spaceth/tigers-x/public/media/mission/dock-poster.jpg

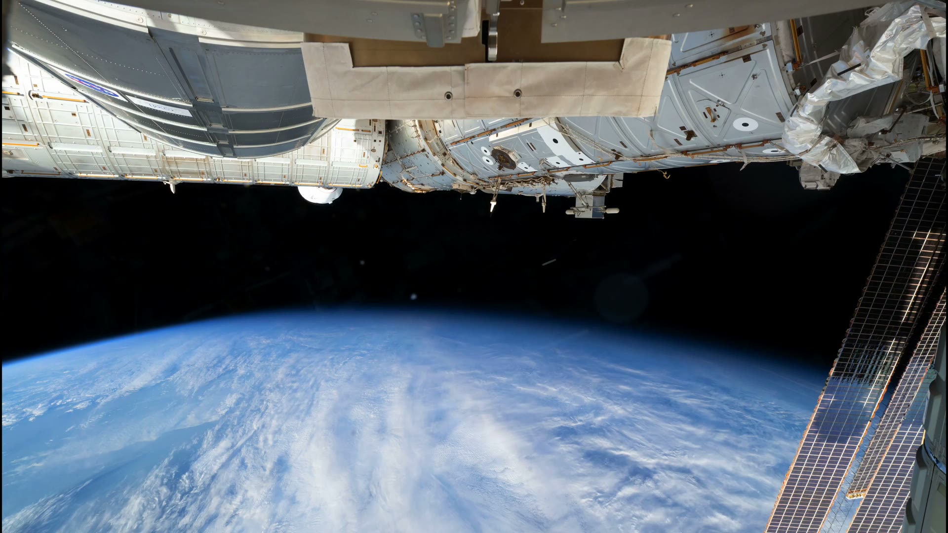
public/media/mission/dock-poster.jpg
