spaceth/tigers-x/public/media/mission/installation-poster.jpg

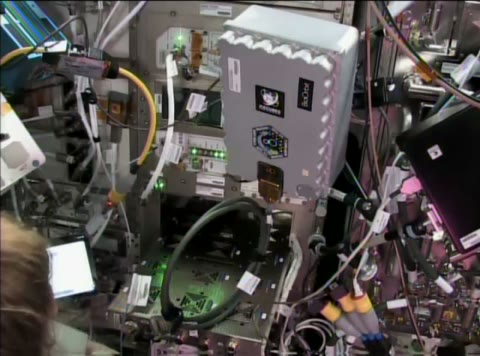
public/media/mission/installation-poster.jpg
