spaceth/tigers-x/command.png

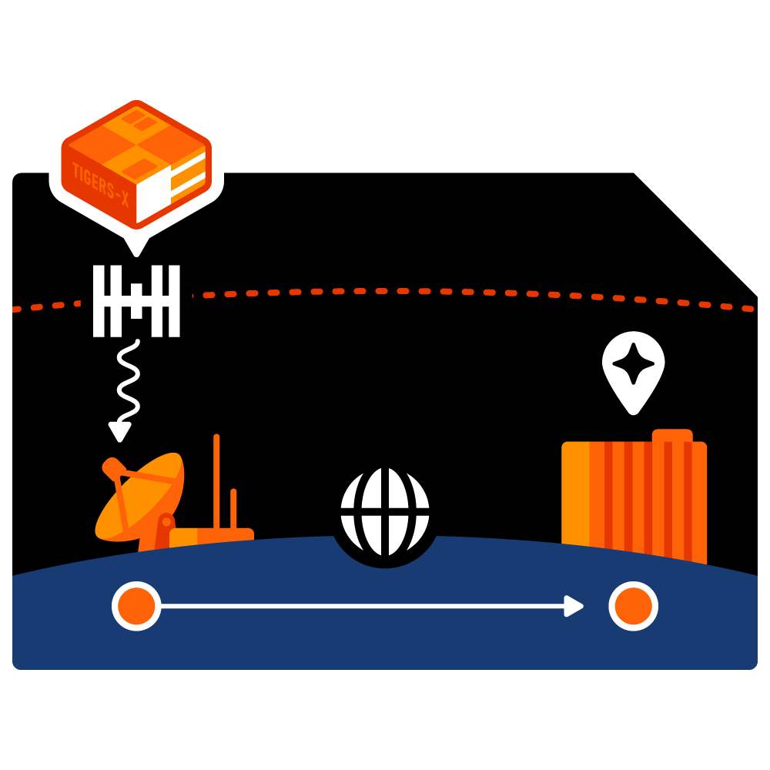
command.png
