spaceth/tigers-x/exploration.png

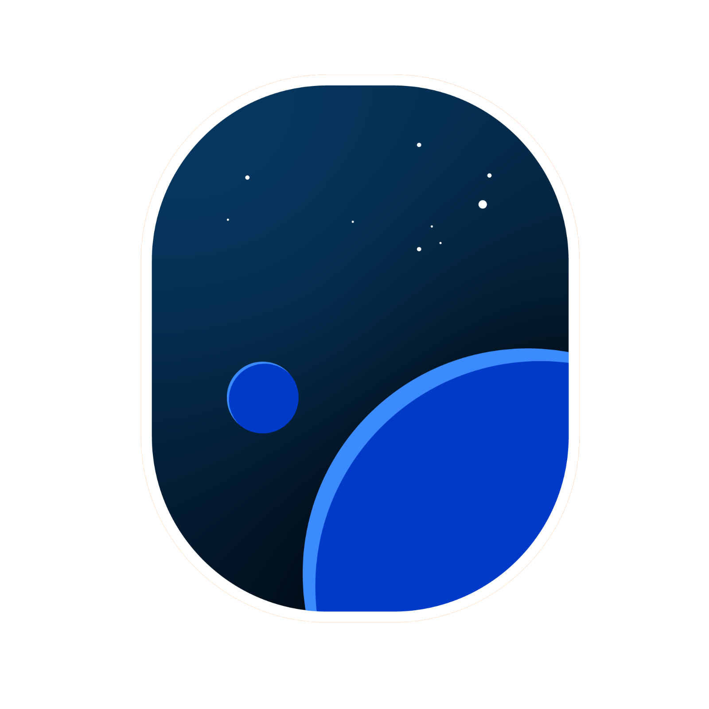
exploration.png
