spaceth/tigers-x/food.png

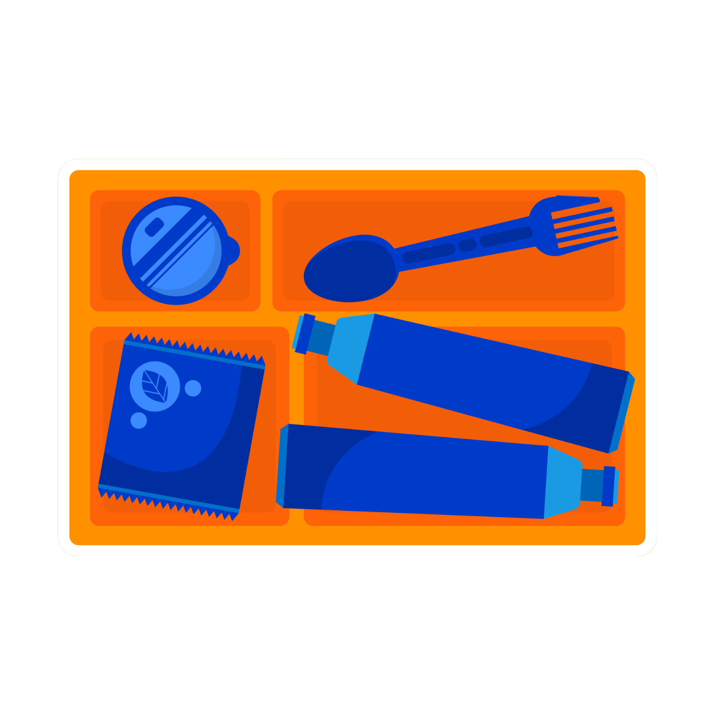
food.png
