spaceth/tigers-x/gistda.webp

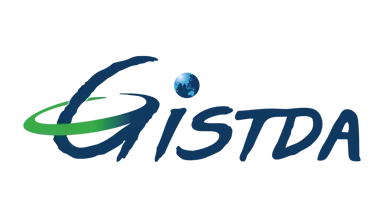
gistda.webp
