spaceth/tigers-x/medical.png

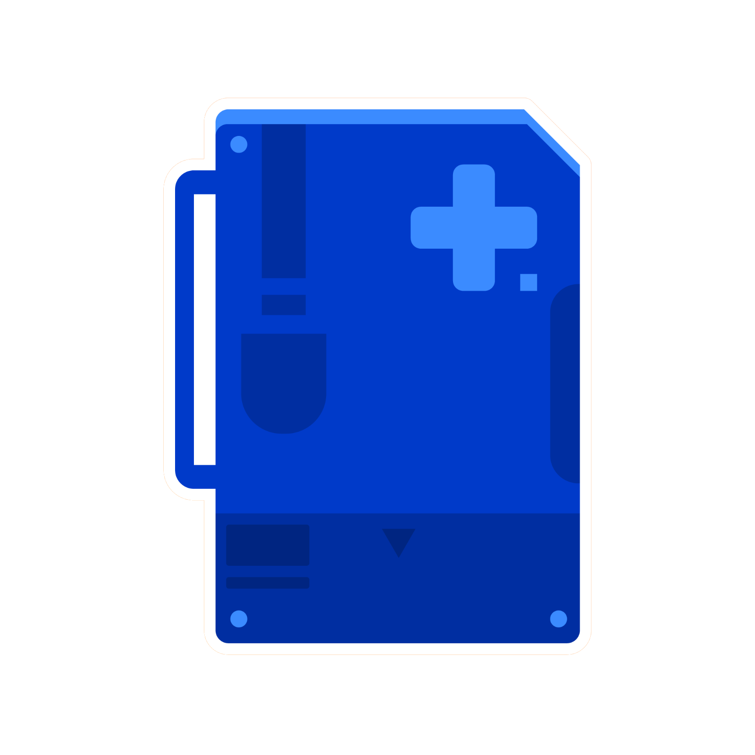
medical.png
