spaceth/tigers-x/og.png

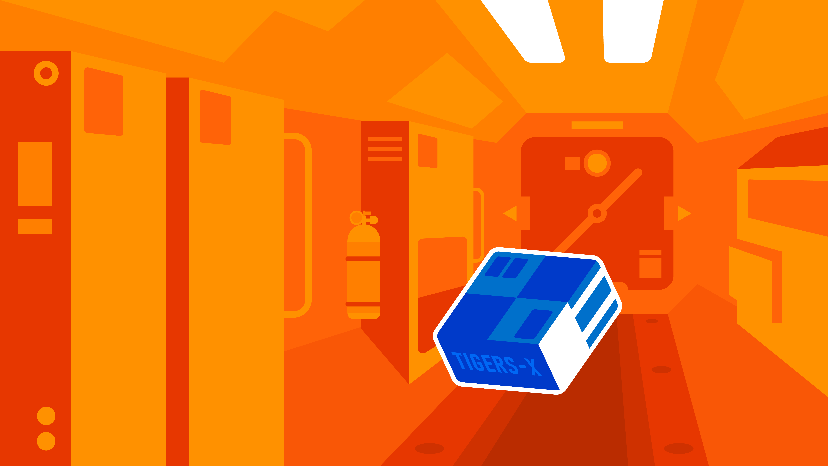
og.png
