spaceth/tigers-x/parabolic.png

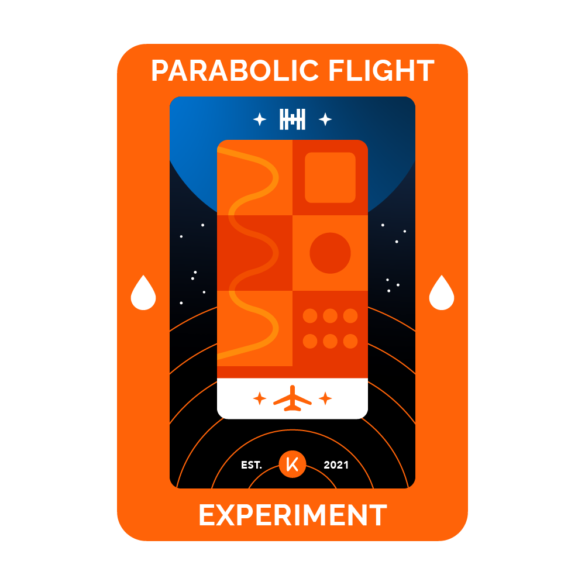
parabolic.png
