spaceth/tigers-x/pim.webp

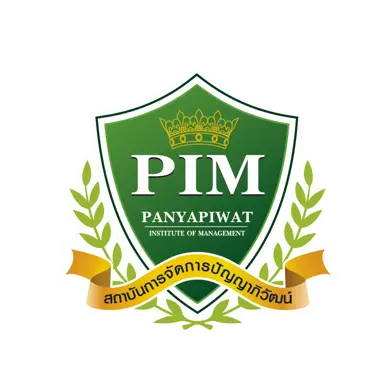
pim.webp
