spaceth/tigers-x/public/media/mission/lab-on-a-chip-poster.jpg

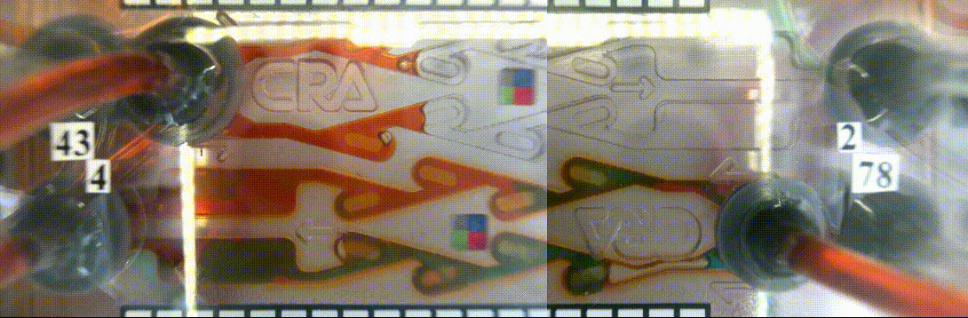
public/media/mission/lab-on-a-chip-poster.jpg
