spaceth/tigers-x/public/media/mission/launch-falcon-9.jpg

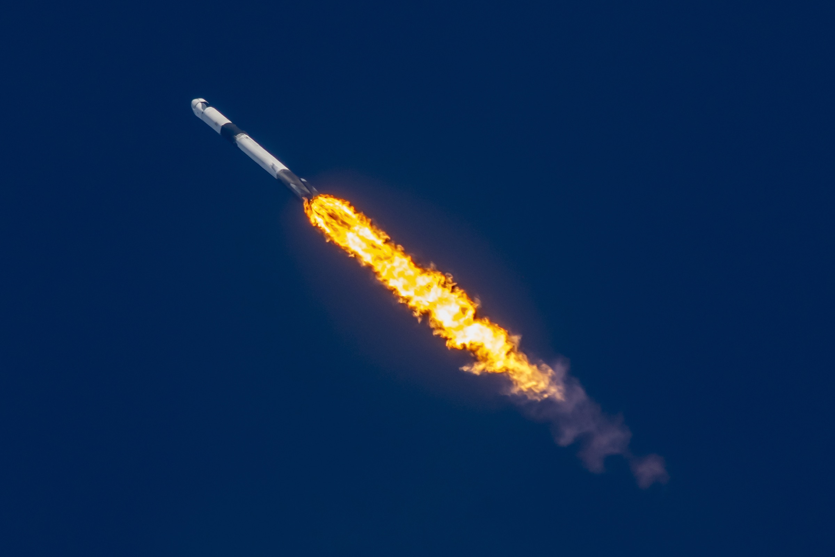
public/media/mission/launch-falcon-9.jpg
