spaceth/tigers-x/public/media/mission/launch-pad-remote.jpg

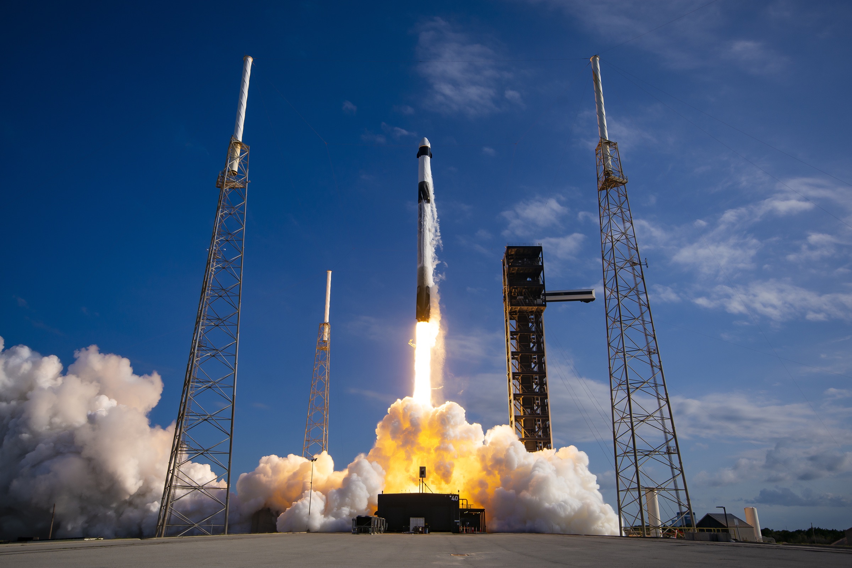
public/media/mission/launch-pad-remote.jpg
