spaceth/tigers-x/public/media/mission/launch.jpg

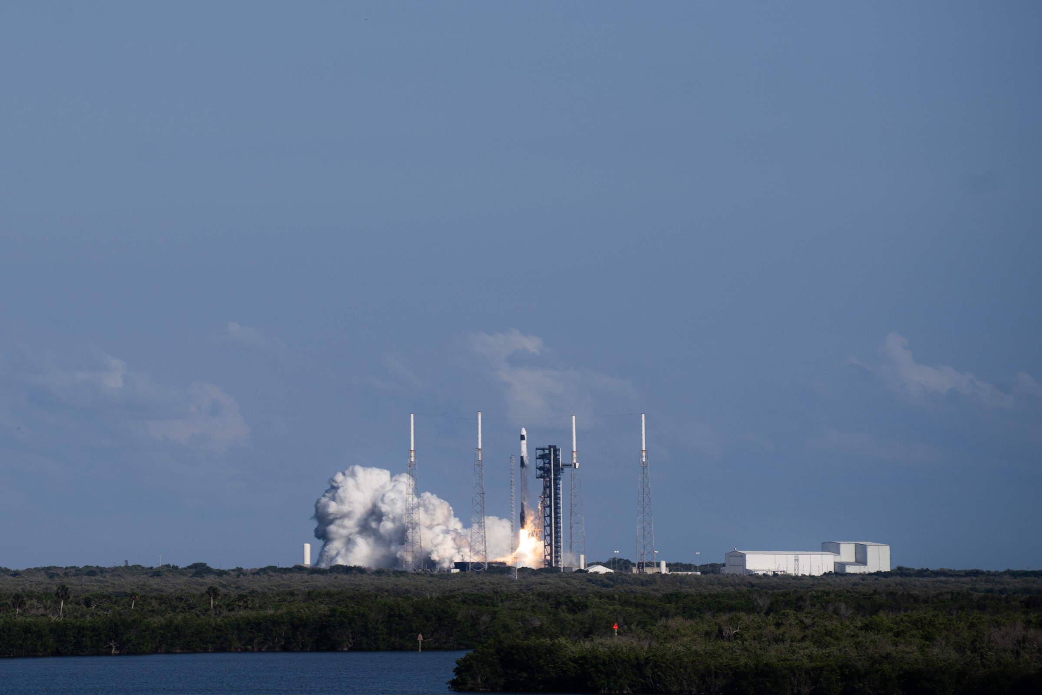
public/media/mission/launch.jpg
