spaceth/tigers-x/public/media/mission/payload-development-1.jpg

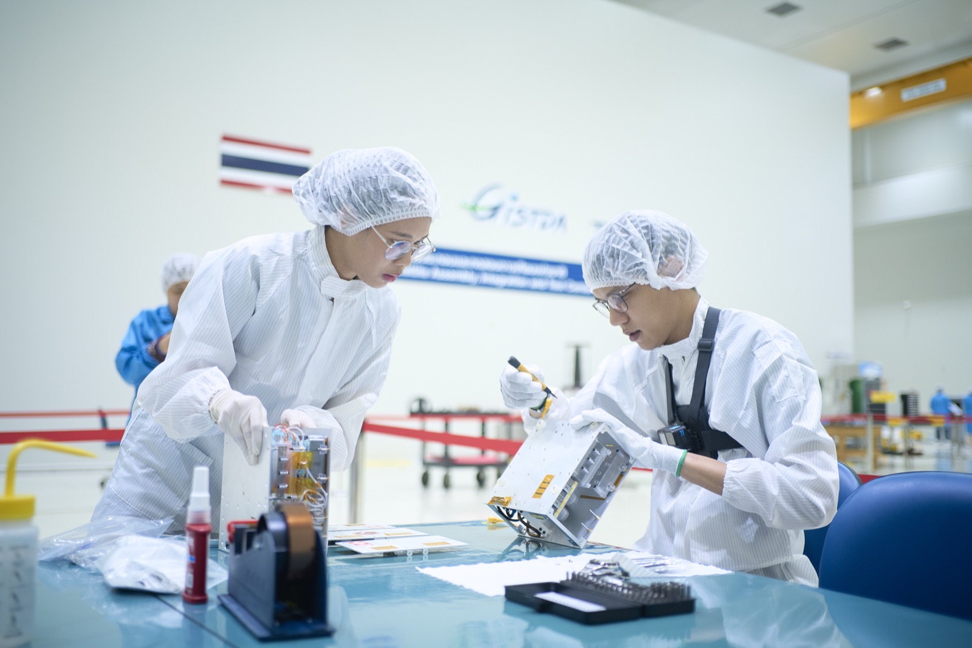
public/media/mission/payload-development-1.jpg
