spaceth/tigers-x/public/media/mission/payload-development-2.jpg

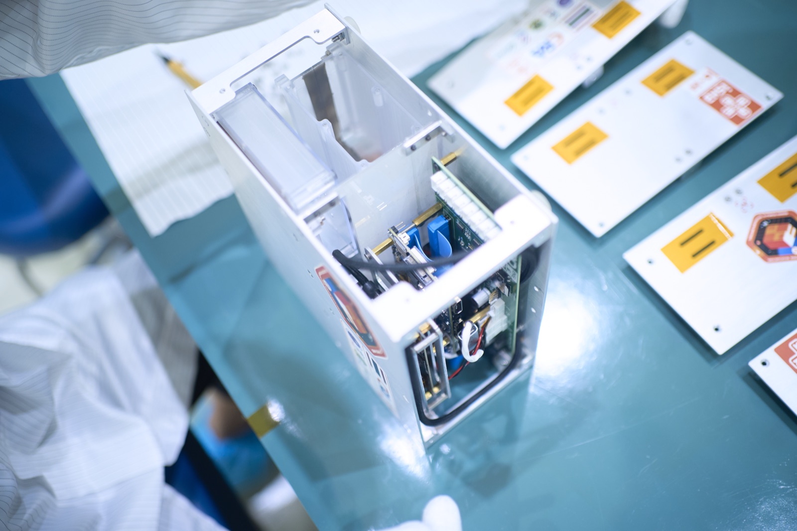
public/media/mission/payload-development-2.jpg
