spaceth/tigers-x/public/media/mission/payload-development-3.jpg

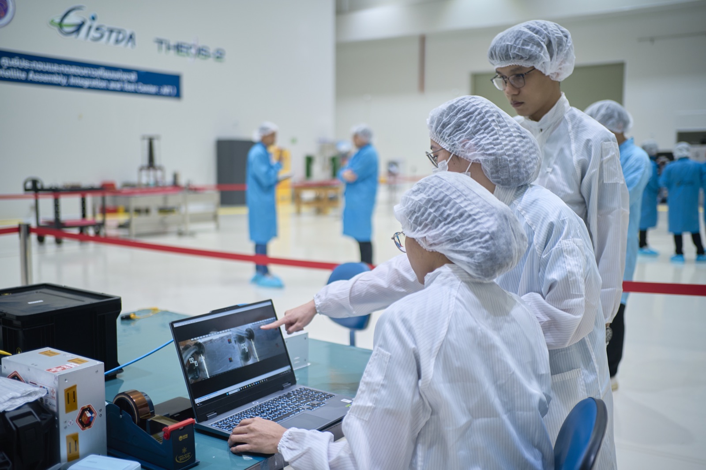
public/media/mission/payload-development-3.jpg
