spaceth/tigers-x/public/media/mission/payload-development-4.jpg

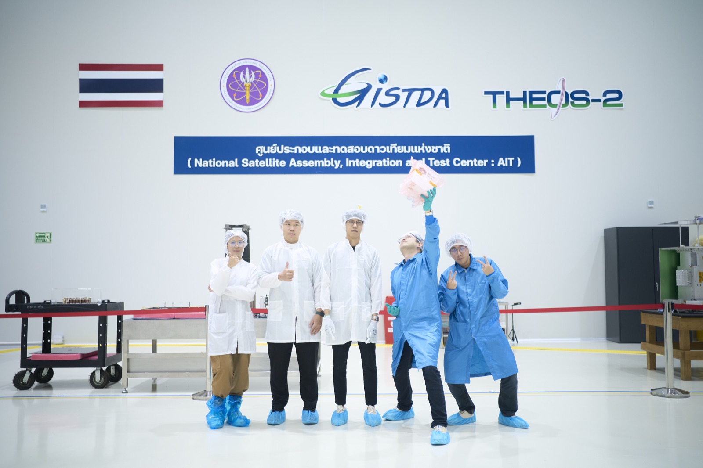
public/media/mission/payload-development-4.jpg
