spaceth/tigers-x/public/media/mission/tigers-x-back.jpg

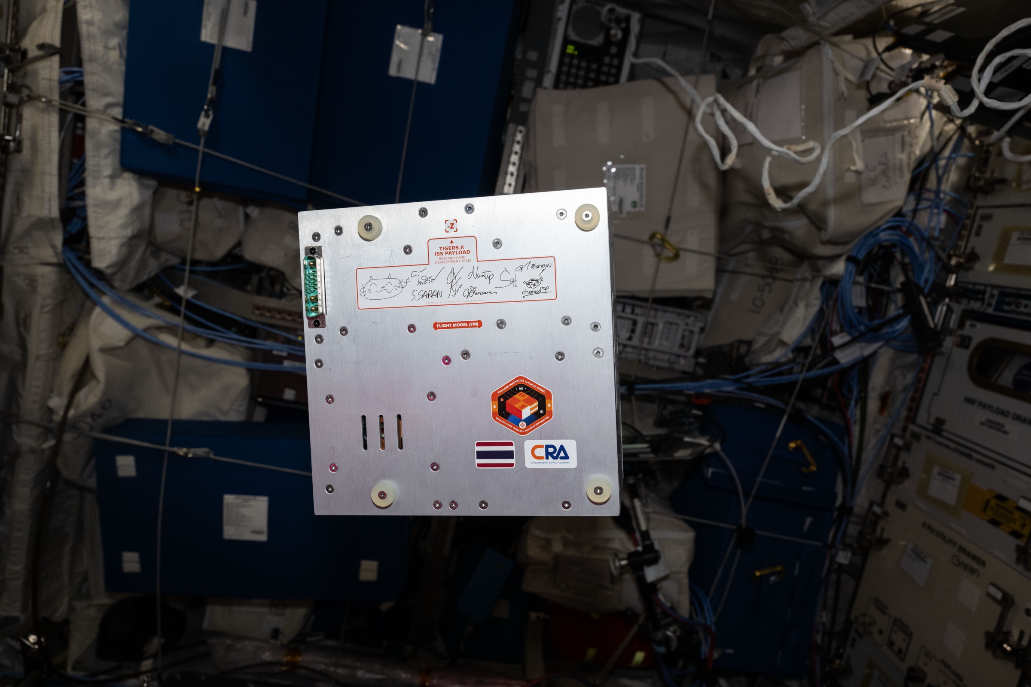
public/media/mission/tigers-x-back.jpg
