spaceth/tigers-x/public/media/mission/tigers-x-floating.jpg

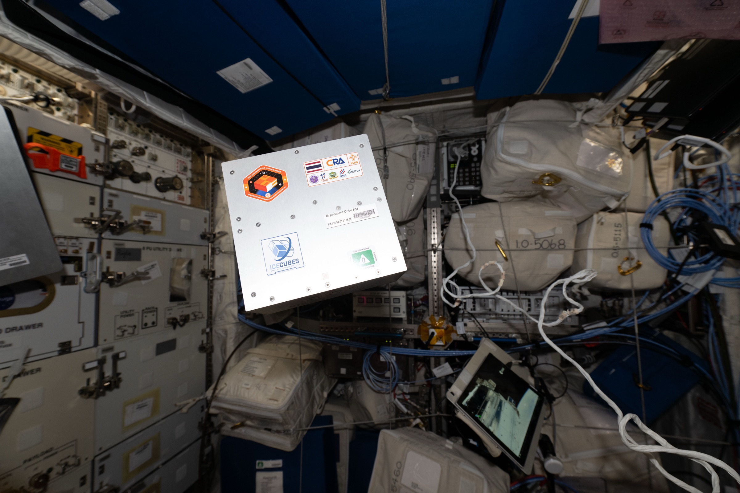
public/media/mission/tigers-x-floating.jpg
