spaceth/tigers-x/public/media/mission/tigers-x-in-icf-2.jpg

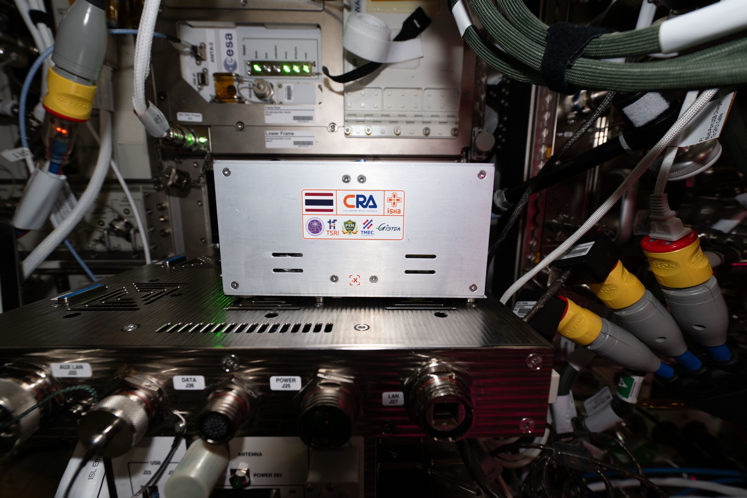
public/media/mission/tigers-x-in-icf-2.jpg
