spaceth/tigers-x/public/media/mission/tigers-x-in-icf-wide.jpg

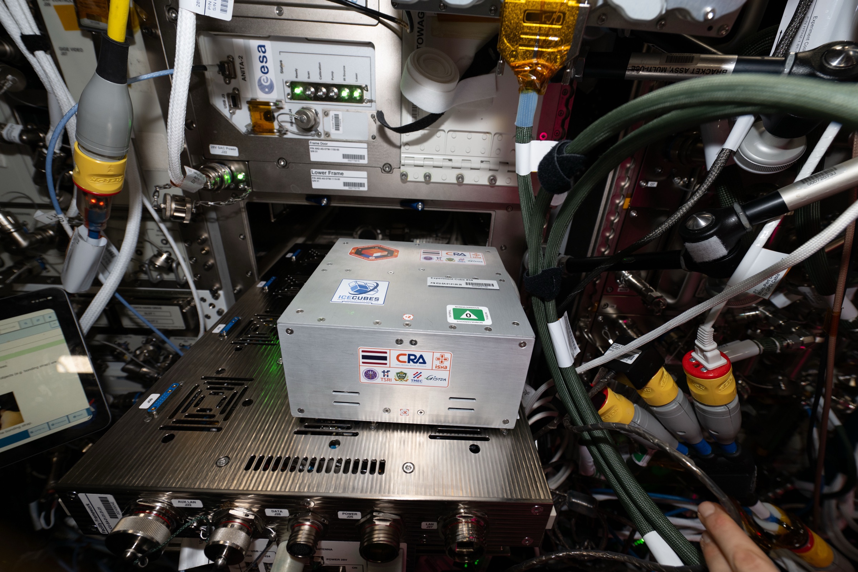
public/media/mission/tigers-x-in-icf-wide.jpg
