spaceth/tigers-x/public/media/mission/undock.jpg

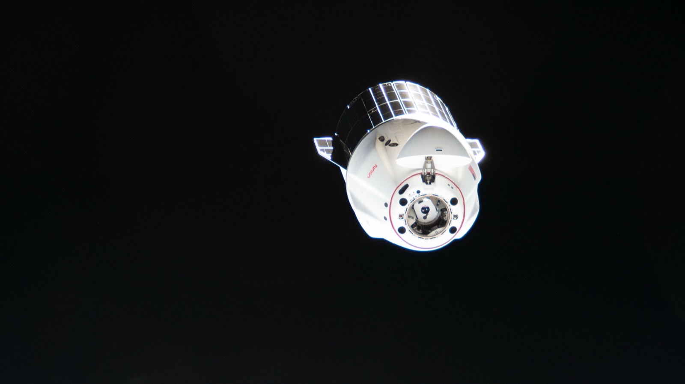
public/media/mission/undock.jpg
