spaceth/tigers-x/public/media/mission/zero-g.jpg

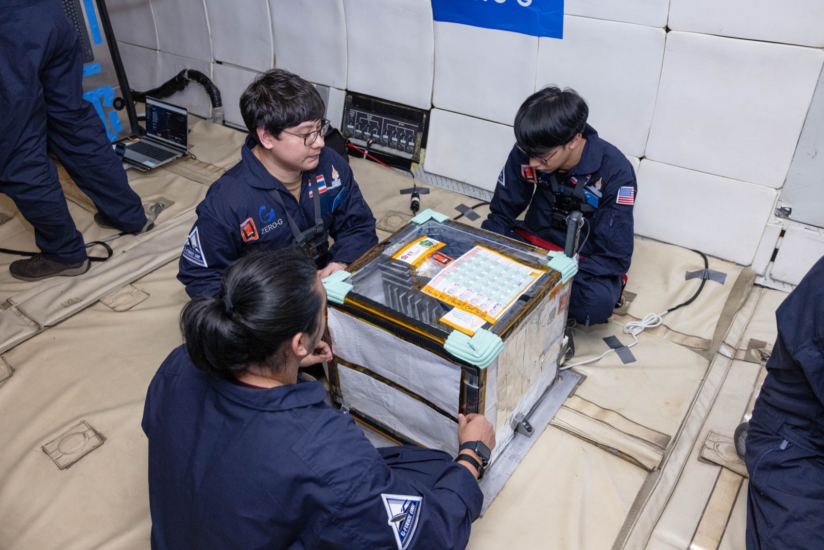
public/media/mission/zero-g.jpg
