spaceth/tigers-x/tmec.webp

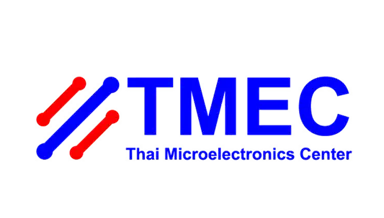
tmec.webp
