spaceth/tigers-x/source/chip-part-x.stl

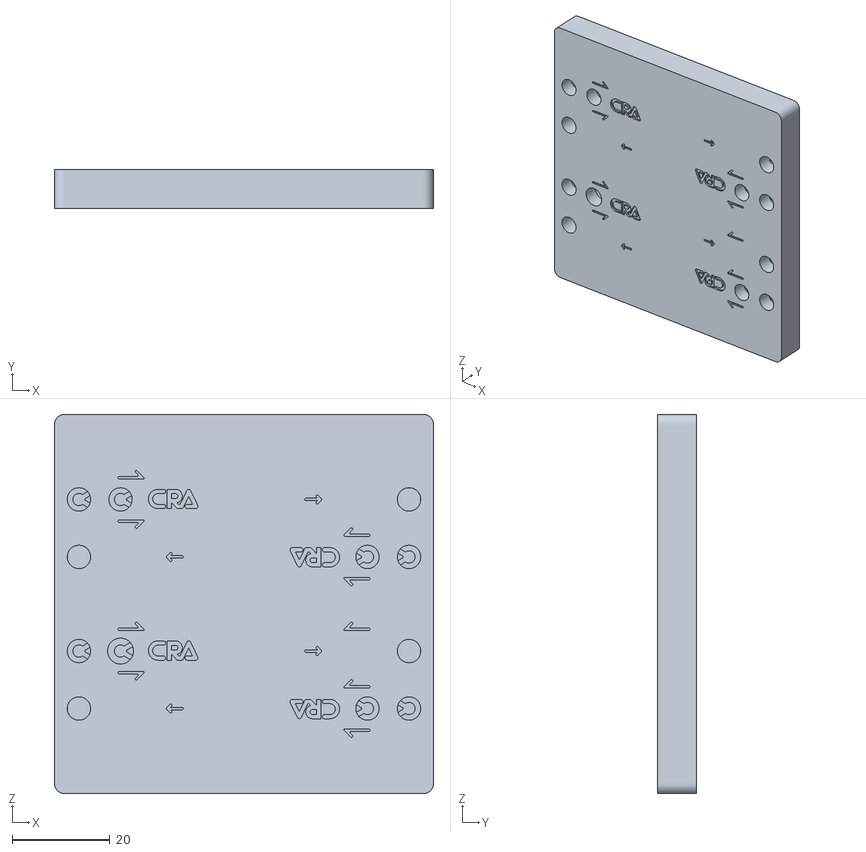
[picture p27: CAD file, 2026-10-25]
source/chip-part-x.stl
77.5 x 8.00 x 77.5
