spaceth/tigers-x/(commit log)

2026-10-21 Build TIGERS-X scroll-driven 3D story site
    Vite + React + three.js single-page story: sticky WebGL stage driven by
    scroll position, exploded subsystem views mapped from the CAD model,
    lab-on-a-chip chapter with a flow diagram drawn on the chip's real channel
    outline (Tesla-valve units), ISS schematic, mission media slots, mission
    record and documentation CTA. Includes asset pipeline scripts, model notes
    and handoff docs.
2026-10-26 Remove the indication dots from the payload explorer buttons.
2026-10-26 Add analytics and an Open Graph image, and turn the resource links into buttons.
2026-10-29 Rewrite the site in the paper’s register and cut the repeated explanations.
2026-11-04 Move site copy into locale JSON and add a language switch, with Thai waiting to be enabled.
2026-11-04 Keep the specification in English and drop its language switch.
    Thai stays a story-site option only; the spec page always reads spec.en.json.
